cgidzinski/CesrfBoard/README.md

# CesrfBoard
Cesrf Board and Schematic Repo
Using Eagle 7.6.0
