cgidzinski/CesrfBoard/Halo_Sense/v1.brd

## EAGLE design Halo_Sense/v1.brd (2016-09-26)

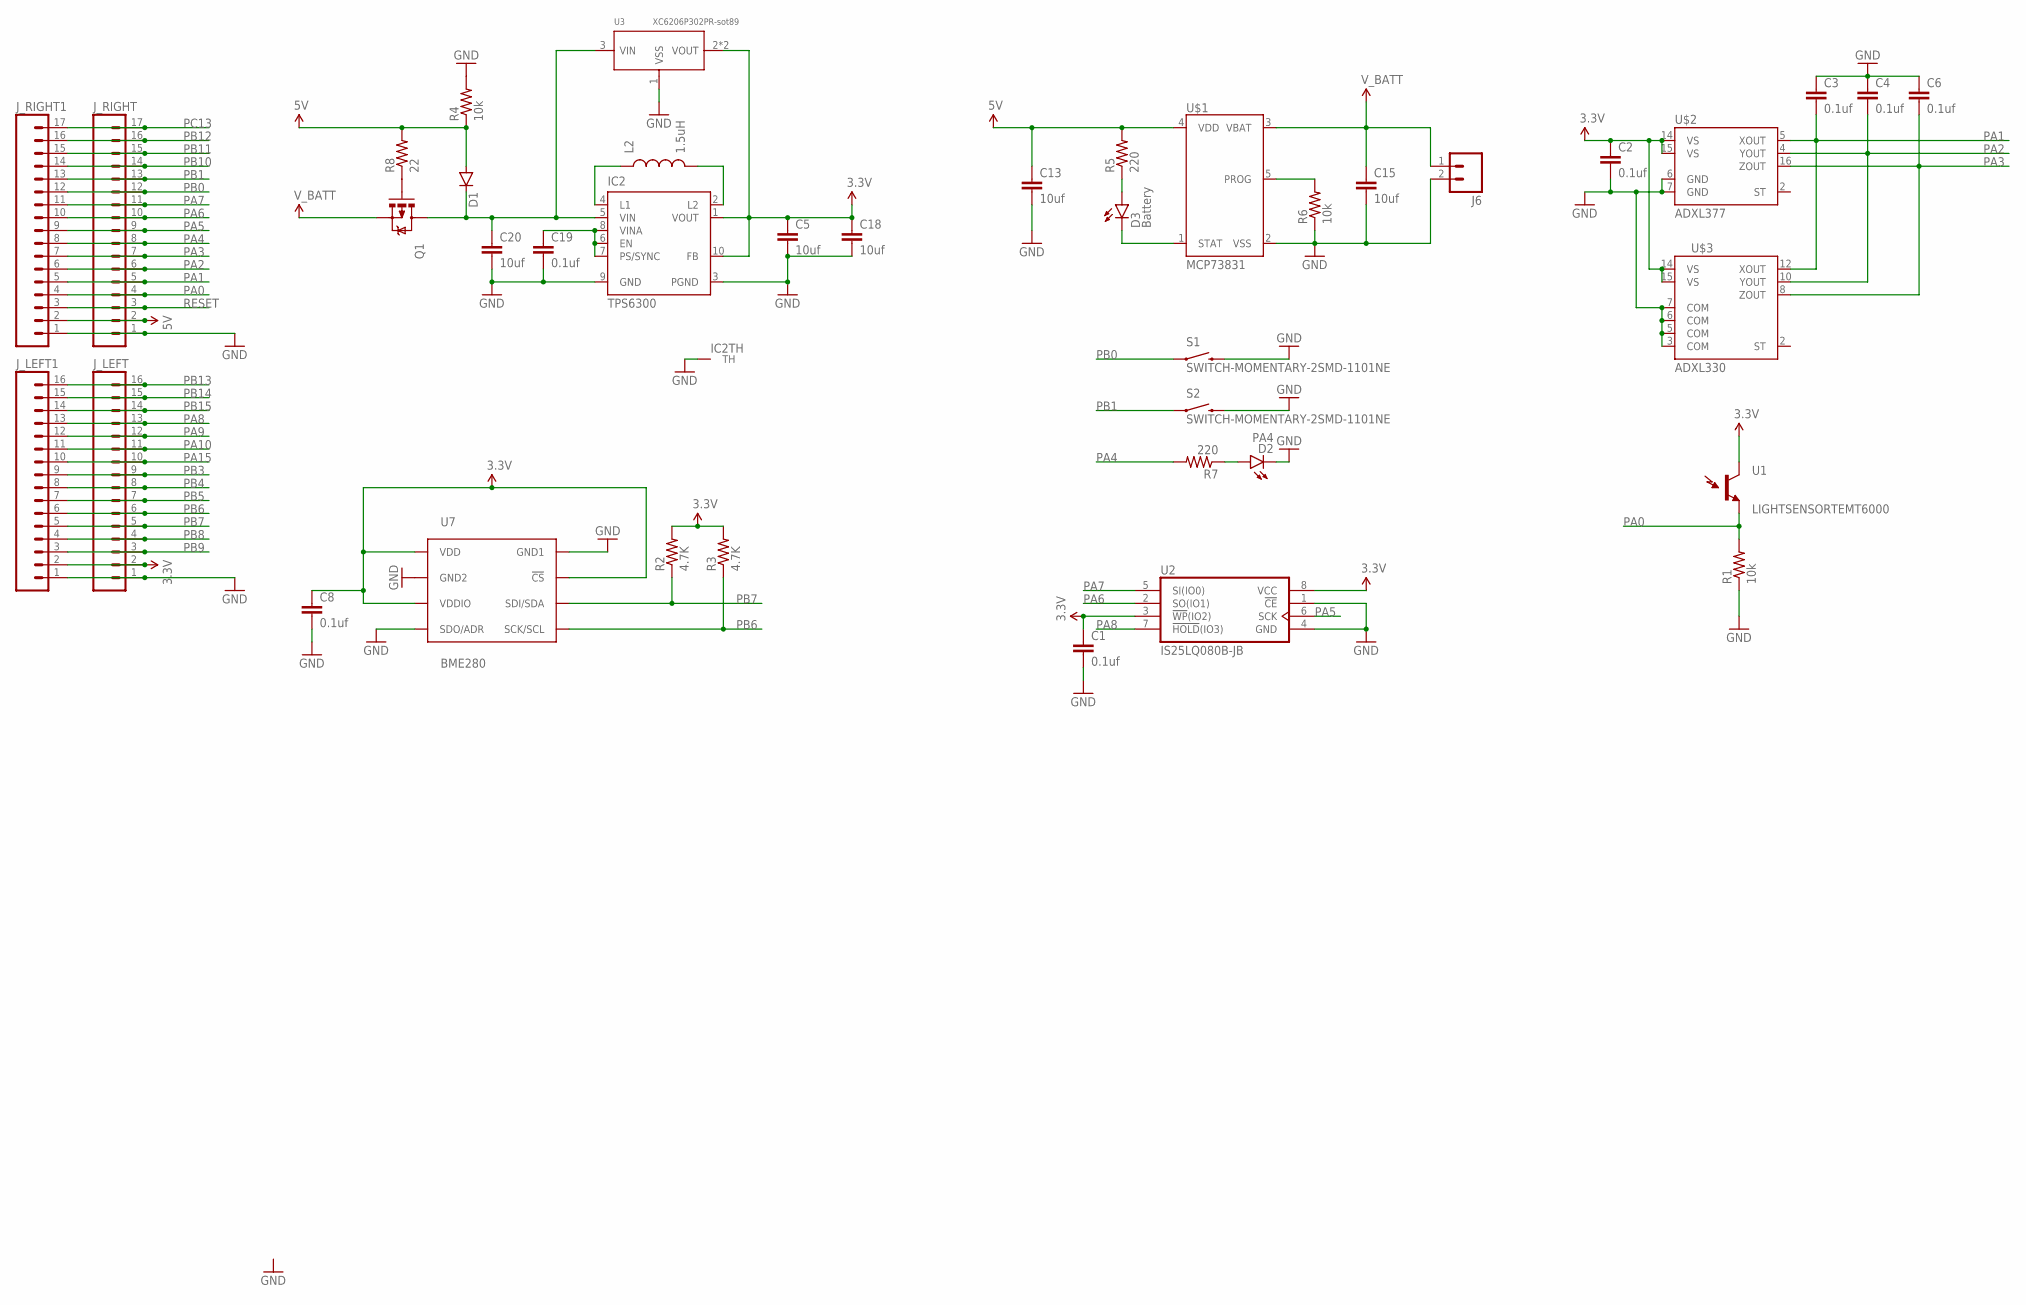
[picture p6: schematic v1.sch]

Parts:
C1, C2, C3, C4, C6, C8, C19: 0.1uf; 0805
C5, C13, C15, C18, C20: 10uf; 0805
D1: DIODESOD123; SOD-123
D2: PA4; LED-1206
D3: Battery; LED-1206
IC2: TPS6300; DRC-S-PVSON-N10
J6: M021X02_NO_SILK; 1X02_NO_SILK
J_LEFT, J_LEFT1: M161X16_NO_SILK; 1X16_NO_SILK
J_RIGHT, J_RIGHT1: M17NOSILK; 1X17_NO_SILK
L2: 1.5uH; SRN6045
Q1: MOSFET-PCHANNEL; SOT23-3
R1, R4, R6: 10k; 0805
R2, R3: 4.7K; 0805
R5, R7: 220; 0805
R8: 22; 0805
S1, S2: SWITCH-MOMENTARY-2SMD-1101NE; TACTILE-SWITCH-1101NE
U1: LIGHTSENSORTEMT6000; TEMT6000-SEN
U2: IS25LQ080B-JB; SO08-JB
U3: XC6206P302PR-sot89; SOT-89
U7: BME280; BME280_LGA
U$1: MCP73831; SOT23-5
U$2: ADXL377; LFCSP_LQ-16
U$3: ADXL330; LFCSP-16

Connections:
3.3V: C1.1, C2.1, C5.1, C8.1, C18.1, IC2.1 (VOUT), IC2.10 (FB), J_LEFT.2, J_LEFT1.2, R2.2, R3.2, U1.COLLECTOR (C1), U2.3 (!WP!(IO2)), U2.8 (VCC), U3.2 (VOUT), U3.4 (VOUT), U7.P$2 (!CS), U7.P$6 (VDDIO), U7.P$8 (VDD), U$2.14 (VS), U$2.15 (VS), U$3.14 (VS), U$3.15 (VS)
5V: C13.1, D1.A, J_RIGHT.2, J_RIGHT1.2, R4.1, R5.2, R8.2, U$1.4 (VDD)
GND: C1.2, C2.2, C3.1, C4.1, C5.2, C6.1, C8.2, C13.2, C15.2, C18.2, C19.2, C20.2, D2.C, IC2.3 (PGND), IC2.9 (GND), IC2.TH, J6.2, J_LEFT.1, J_LEFT1.1, J_RIGHT.1, J_RIGHT1.1, R1.1, R4.2, R6.1, S1.2, S2.2, U2.1 (!CE!), U2.4 (GND), U3.1 (VSS), U7.P$1 (GND1), U7.P$5 (SDO/ADR), U7.P$7 (GND2), U$1.2 (VSS), U$2.6 (GND), U$2.7 (GND), U$3.3 (COM), U$3.5 (COM), U$3.6 (COM), U$3.7 (COM)
unnamed: IC2.4 (L1), L2.1
unnamed: IC2.2 (L2), L2.2
unnamed: C20.1, D1.C, IC2.5 (VIN), Q1.3 (D), U3.3 (VIN)
unnamed: D2.A, R7.1
unnamed: Q1.1 (G), R8.1
unnamed: D3.A, R5.1
unnamed: C19.1, IC2.6 (EN), IC2.7 (PS/SYNC), IC2.8 (VINA)
unnamed: D3.C, U$1.1 (STAT)
unnamed: R6.2, U$1.5 (PROG)
PA0: J_RIGHT.4, J_RIGHT1.4, R1.2, U1.EMITTER (E1)
PA1: C3.2, J_RIGHT.5, J_RIGHT1.5, U$2.5 (XOUT), U$3.12 (XOUT)
PA2: C4.2, J_RIGHT.6, J_RIGHT1.6, U$2.4 (YOUT), U$3.10 (YOUT)
PA3: C6.2, J_RIGHT.7, J_RIGHT1.7, U$2.16 (ZOUT), U$3.8 (ZOUT)
PA4: J_RIGHT.8, J_RIGHT1.8, R7.2
PA5: J_RIGHT.9, J_RIGHT1.9, U2.6 (SCK)
PA6: J_RIGHT.10, J_RIGHT1.10, U2.2 (SO(IO1))
PA7: J_RIGHT.11, J_RIGHT1.11, U2.5 (SI(IO0))
PA8: J_LEFT.13, J_LEFT1.13, U2.7 (!HOLD!(IO3))
PA9: J_LEFT.12, J_LEFT1.12
PA10: J_LEFT.11, J_LEFT1.11
PA15: J_LEFT.10, J_LEFT1.10
PB0: J_RIGHT.12, J_RIGHT1.12, S1.1
PB1: J_RIGHT.13, J_RIGHT1.13, S2.1
PB3: J_LEFT.9, J_LEFT1.9
PB4: J_LEFT.8, J_LEFT1.8
PB5: J_LEFT.7, J_LEFT1.7
PB6: J_LEFT.6, J_LEFT1.6, R3.1, U7.P$4 (SCK/SCL)
PB7: J_LEFT.5, J_LEFT1.5, R2.1, U7.P$3 (SDI/SDA)
PB8: J_LEFT.4, J_LEFT1.4
PB9: J_LEFT.3, J_LEFT1.3
PB10: J_RIGHT.14, J_RIGHT1.14
PB11: J_RIGHT.15, J_RIGHT1.15
PB12: J_RIGHT.16, J_RIGHT1.16
PB13: J_LEFT.16, J_LEFT1.16
PB14: J_LEFT.15, J_LEFT1.15
PB15: J_LEFT.14, J_LEFT1.14
PC13: J_RIGHT.17, J_RIGHT1.17
RESET: J_RIGHT.3, J_RIGHT1.3
V_BATT: C15.1, J6.1, Q1.2 (S), U$1.3 (VBAT)

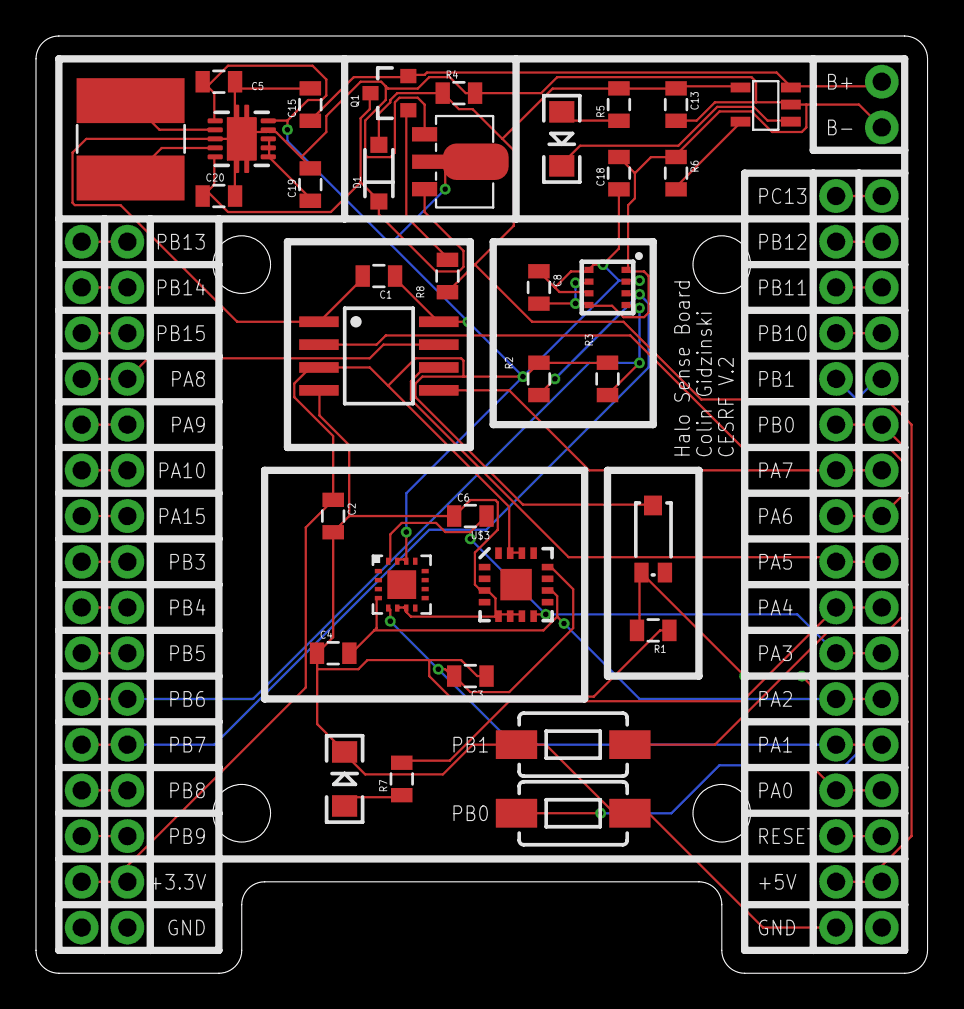
[picture p7: board Halo_Sense/v1.brd from above]

Board: 2 copper layers, 49.5 x 52.1 mm, 40 parts (0 on the bottom side), 42 nets.
