cgidzinski/CesrfBoard/Halo_Mini/v1.brd

## EAGLE design Halo_Mini/v1.brd (2016-09-26)

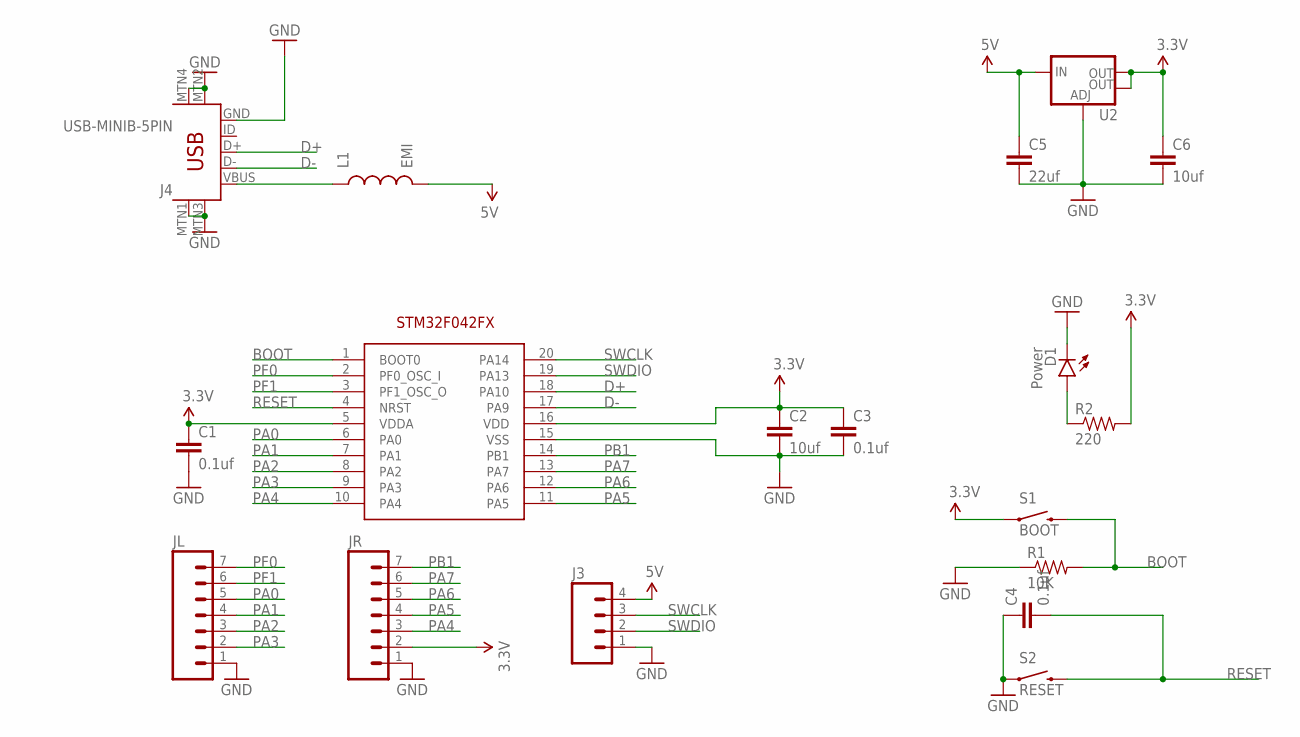
[picture p8: schematic v1.sch]

Parts:
C1, C3, C4: 0.1uf; 0805
C2, C6: 10uf; 0805
C5: 22uf; 0805
D1: Power; LED-1206
J3: M04NO_SILK_ALL_ROUND; 1X04_NO_SILK_ALL_ROUND
J4: USB-MINIB-5PIN; USB-MINIB
JL: M07NO_SILK; 1X07_NO_SILK
JR: M07NO_SILK; 1X07_NO_SILK
L1: EMI; 0805
R1: 10K; 0805
R2: 220; 0805
S1: BOOT; TACTILE-SWITCH-1101NE
S2: RESET; TACTILE-SWITCH-1101NE
U1: STM32F042FX; TSSOP20
U2: V_REG_LM1117SOT223; SOT223

Connections:
3.3V: C1.1, C2.1, C3.1, C6.1, JR.2, R2.2, S1.1, U1.5 (VDDA), U1.16 (VDD), U2.2 (OUT), U2.4 (OUT)
5V: C5.1, J3.4, L1.2, U2.3 (IN)
BOOT: R1.2, S1.2, U1.1 (BOOT0)
D+: J4.D+, U1.18 (PA10)
D-: J4.D-, U1.17 (PA9)
GND: C1.2, C2.2, C3.2, C4.1, C5.2, C6.2, D1.C, J3.1, J4.GND, J4.MTN1 (MTN2), J4.MTN2 (MTN3), J4.MTN3 (MTN1), J4.MTN4, JL.1, JR.1, R1.1, S2.1, U1.15 (VSS), U2.1 (ADJ)
unnamed: D1.A, R2.1
unnamed: J4.VBUS, L1.1
PA0: JL.5, U1.6 (PA0)
PA1: JL.4, U1.7 (PA1)
PA2: JL.3, U1.8 (PA2)
PA3: JL.2, U1.9 (PA3)
PA4: JR.3, U1.10 (PA4)
PA5: JR.4, U1.11 (PA5)
PA6: JR.5, U1.12 (PA6)
PA7: JR.6, U1.13 (PA7)
PB1: JR.7, U1.14 (PB1)
PF0: JL.7, U1.2 (PF0_OSC_I)
PF1: JL.6, U1.3 (PF1_OSC_O)
RESET: C4.2, S2.2, U1.4 (NRST)
SWCLK: J3.3, U1.20 (PA14)
SWDIO: J3.2, U1.19 (PA13)

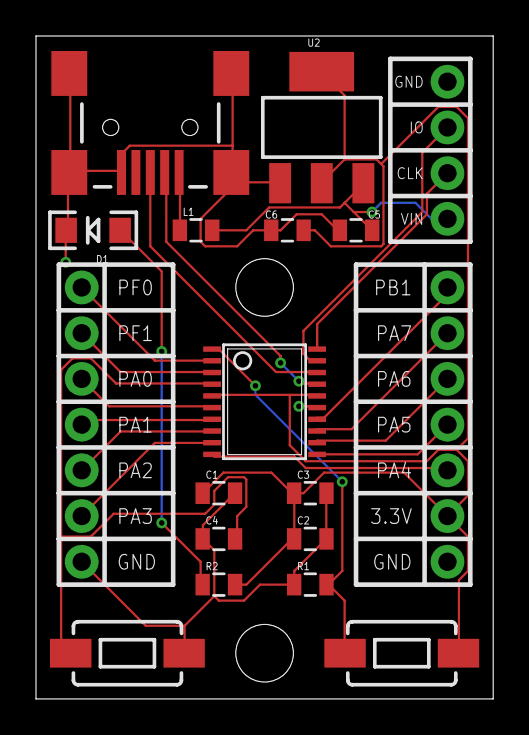
[picture p9: board Halo_Mini/v1.brd from above]

Board: 2 copper layers, 25.4 x 36.8 mm, 18 parts (0 on the bottom side), 22 nets.
