cgidzinski/CesrfBoard/Halo_Main/v1.brd

## EAGLE design Halo_Main/v1.brd (2016-09-26)

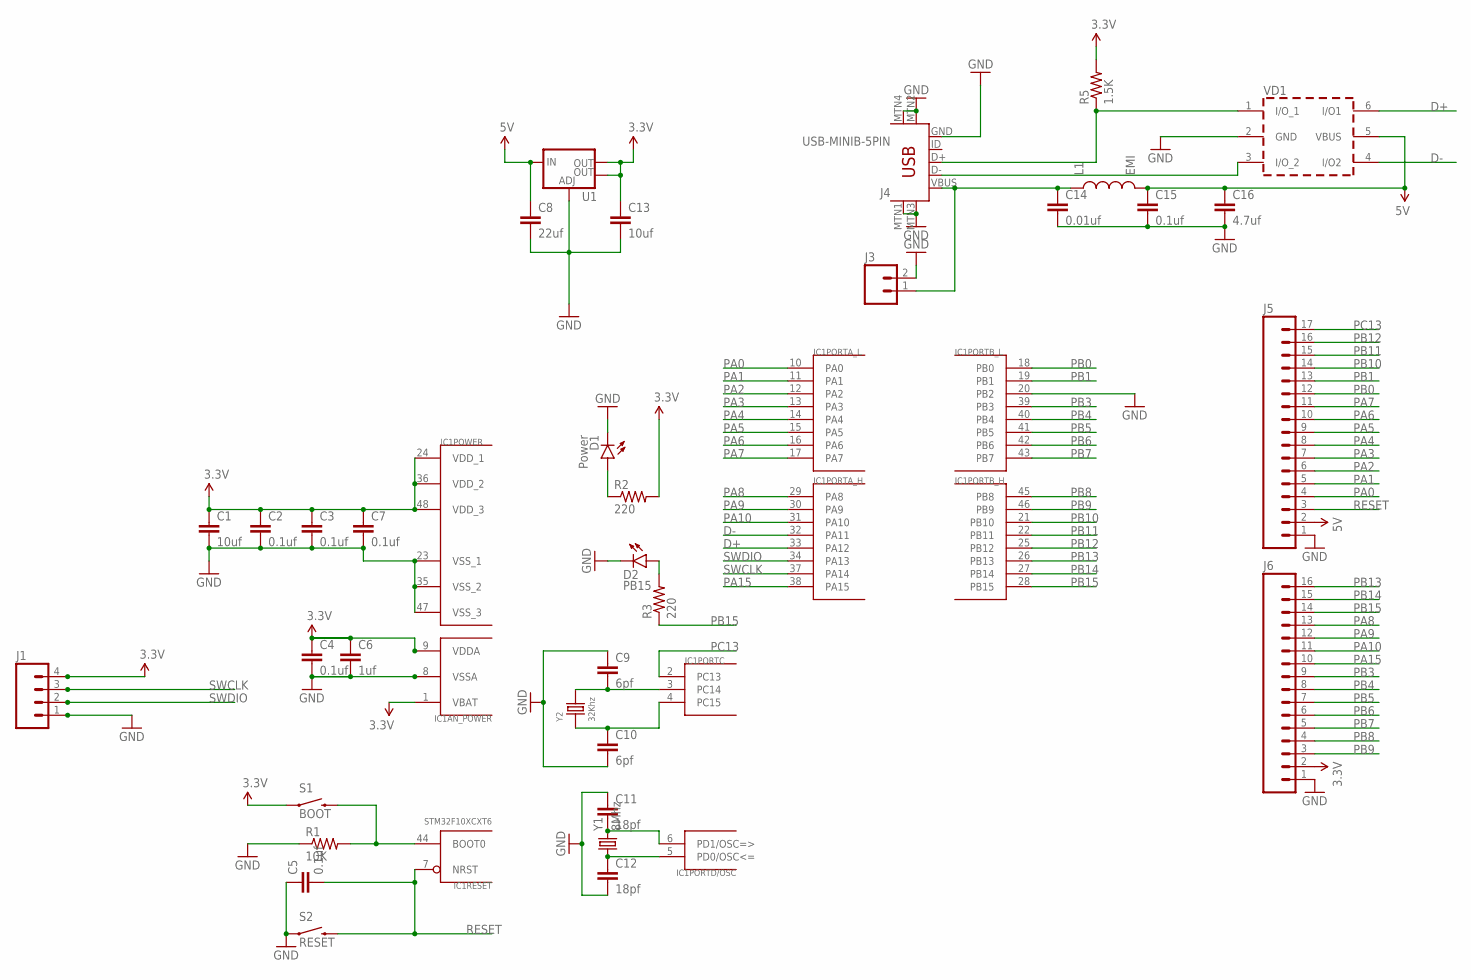
[picture p10: schematic v1.sch]

Parts:
C1, C13: 10uf; 0805
C2, C3, C4, C5, C7, C15: 0.1uf; 0805
C6: 1uf; 0805
C8: 22uf; 0805
C9, C10: 6pf; 0805
C11, C12: 18pf; 0805
C14: 0.01uf; 0805
C16: 4.7uf; 0805
D1: Power; LED-1206
D2: PB15; LED-1206
IC1: STM32F10XCXT6; TQFP48
J1: M04NO_SILK_ALL_ROUND; 1X04_NO_SILK_ALL_ROUND
J3: M021X02_NO_SILK; 1X02_NO_SILK
J4: USB-MINIB-5PIN; USB-MINIB
J5: M17NOSILK; 1X17_NO_SILK
J6: M161X16_NO_SILK; 1X16_NO_SILK
L1: EMI; 0805
R1: 10K; 0805
R2, R3: 220; 0805
R5: 1.5K; 0805
S1: BOOT; TACTILE-SWITCH-1101NE
S2: RESET; TACTILE-SWITCH-1101NE
U1: V_REG_LM1117SOT223; SOT223
VD1: USBLC6-2SC6; SOT-23-6L
Y1: 8Mhz; CRYSTAL-SMD-5X3
Y2: 32Khz; X2-SMD-3.2X1.5X0.55MM

Connections:
3.3V: C1.1, C2.1, C3.1, C4.1, C6.1, C7.1, C13.1, IC1.1 (VBAT), IC1.9 (VDDA), IC1.24 (VDD_1), IC1.36 (VDD_2), IC1.48 (VDD_3), J1.4, J6.2, R2.2, R5.2, S1.1, U1.2 (OUT), U1.4 (OUT)
5V: C8.1, C15.1, C16.1, J5.2, L1.2, U1.3 (IN), VD1.5 (VBUS)
D+: IC1.33 (PA12), VD1.6 (I/O1)
D-: IC1.32 (PA11), VD1.4 (I/O2)
GND: C1.2, C2.2, C3.2, C4.2, C5.1, C6.2, C7.2, C8.2, C9.1, C10.2, C11.1, C12.2, C13.2, C14.2, C15.2, C16.2, D1.C, D2.C, IC1.8 (VSSA), IC1.20 (PB2), IC1.23 (VSS_1), IC1.35 (VSS_2), IC1.47 (VSS_3), J1.1, J3.2, J4.GND, J4.MTN1 (MTN2), J4.MTN2 (MTN3), J4.MTN3 (MTN1), J4.MTN4, J5.1, J6.1, R1.1, S2.1, U1.1 (ADJ), VD1.2 (GND)
unnamed: D1.A, R2.1
unnamed: IC1.44 (BOOT0), R1.2, S1.2
unnamed: C11.2, IC1.6 (PD1/OSC=>), Y1.3 (2)
unnamed: C12.1, IC1.5 (PD0/OSC<=), Y1.1
unnamed: C9.2, IC1.3 (PC14), Y2.2
unnamed: D2.A, R3.2
unnamed: C10.1, IC1.4 (PC15), Y2.1
unnamed: C14.1, J3.1, J4.VBUS, L1.1
unnamed: J4.D+, R5.1, VD1.1 (I/O_1)
unnamed: J4.D-, VD1.3 (I/O_2)
PA0: IC1.10 (PA0), J5.4
PA1: IC1.11 (PA1), J5.5
PA2: IC1.12 (PA2), J5.6
PA3: IC1.13 (PA3), J5.7
PA4: IC1.14 (PA4), J5.8
PA5: IC1.15 (PA5), J5.9
PA6: IC1.16 (PA6), J5.10
PA7: IC1.17 (PA7), J5.11
PA8: IC1.29 (PA8), J6.13
PA9: IC1.30 (PA9), J6.12
PA10: IC1.31 (PA10), J6.11
PA15: IC1.38 (PA15), J6.10
PB0: IC1.18 (PB0), J5.12
PB1: IC1.19 (PB1), J5.13
PB3: IC1.39 (PB3), J6.9
PB4: IC1.40 (PB4), J6.8
PB5: IC1.41 (PB5), J6.7
PB6: IC1.42 (PB6), J6.6
PB7: IC1.43 (PB7), J6.5
PB8: IC1.45 (PB8), J6.4
PB9: IC1.46 (PB9), J6.3
PB10: IC1.21 (PB10), J5.14
PB11: IC1.22 (PB11), J5.15
PB12: IC1.25 (PB12), J5.16
PB13: IC1.26 (PB13), J6.16
PB14: IC1.27 (PB14), J6.15
PB15: IC1.28 (PB15), J6.14, R3.1
PC13: IC1.2 (PC13), J5.17
RESET: C5.2, IC1.7 (NRST), J5.3, S2.2
SWCLK: IC1.37 (PA14), J1.3
SWDIO: IC1.34 (PA13), J1.2

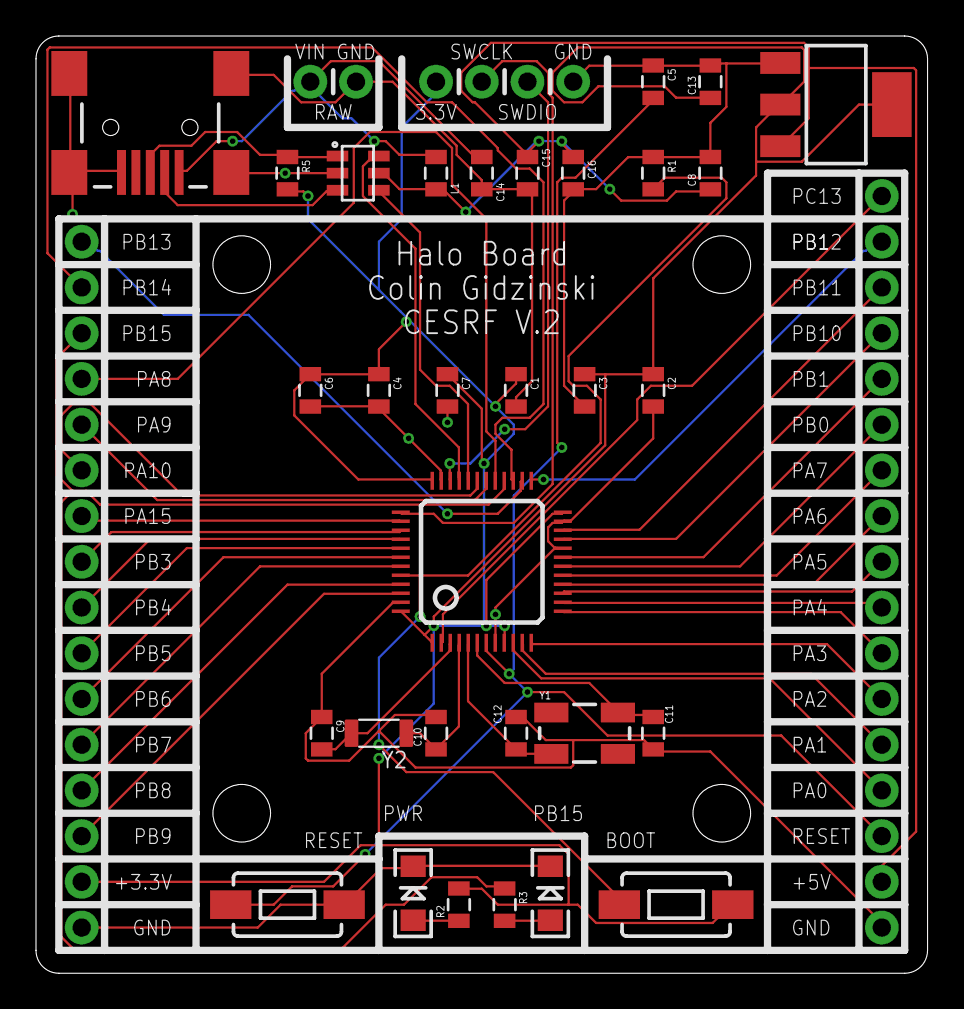
[picture p11: board Halo_Main/v1.brd from above]

Board: 2 copper layers, 49.5 x 52.1 mm, 35 parts (0 on the bottom side), 46 nets.
