cgidzinski/CesrfBoard/(commit log)

2016-09-26 Base Files
    [v1.brd, v1.dxf, v1.sch]
2016-09-26 Added Documentation
    [v1.brd, v1.sch]
