cgidzinski/CesrfBoard/(notices)

Notices in the files:
parts and their libraries:
SparkFun-Capacitors: Licensing: Creative Commons ShareAlike 4.0 International - https://creativecommons.org/licenses/by-sa/4.0
memory-issi: Copyright (C) 2015, Bob Starr
